xdylanm/noise/README.md

# Random Noise

A module in the Eurorack format for generating various types of noise.
