xdylanm/noise/docs/assets/images/BN_1K.png

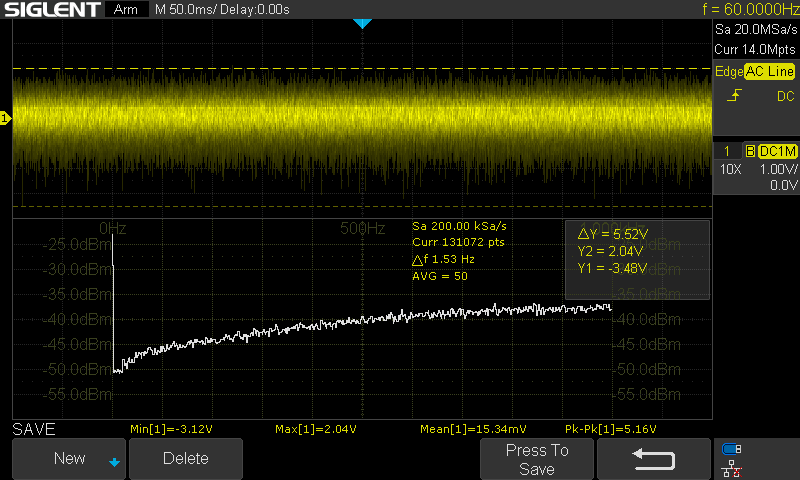
docs/assets/images/BN_1K.png
