xdylanm/noise/docs/assets/images/BN_10K.png

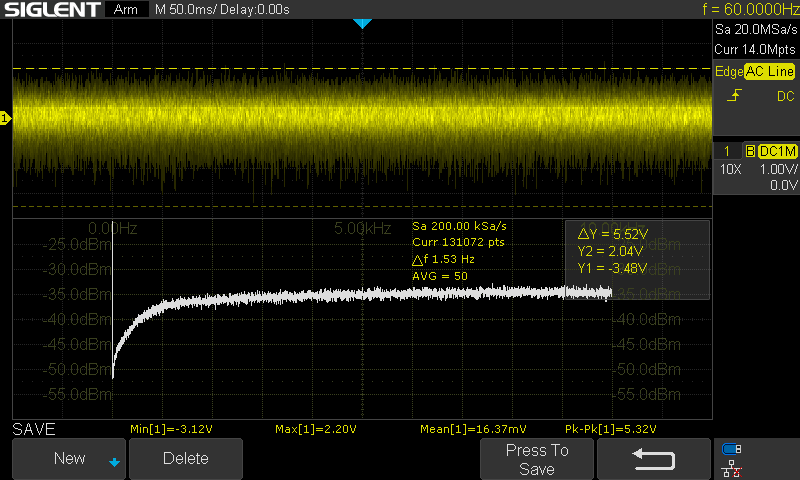
docs/assets/images/BN_10K.png
