xdylanm/noise/docs/assets/images/PN_10K.png

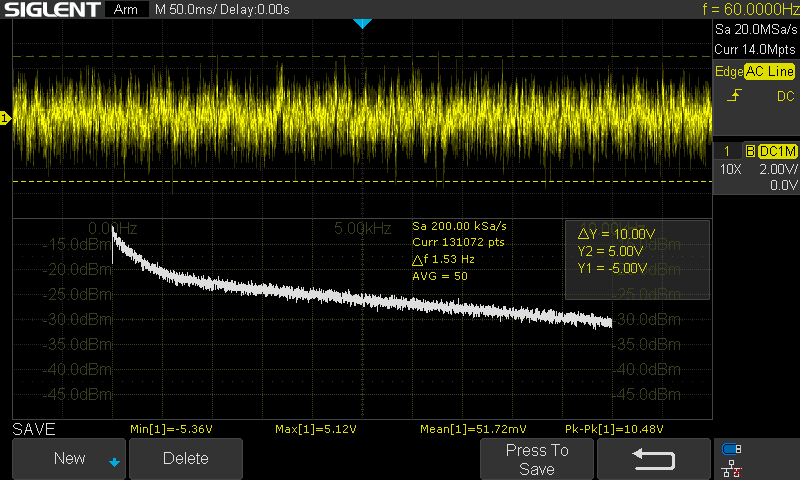
docs/assets/images/PN_10K.png
