xdylanm/noise/docs/assets/schematic.pdf

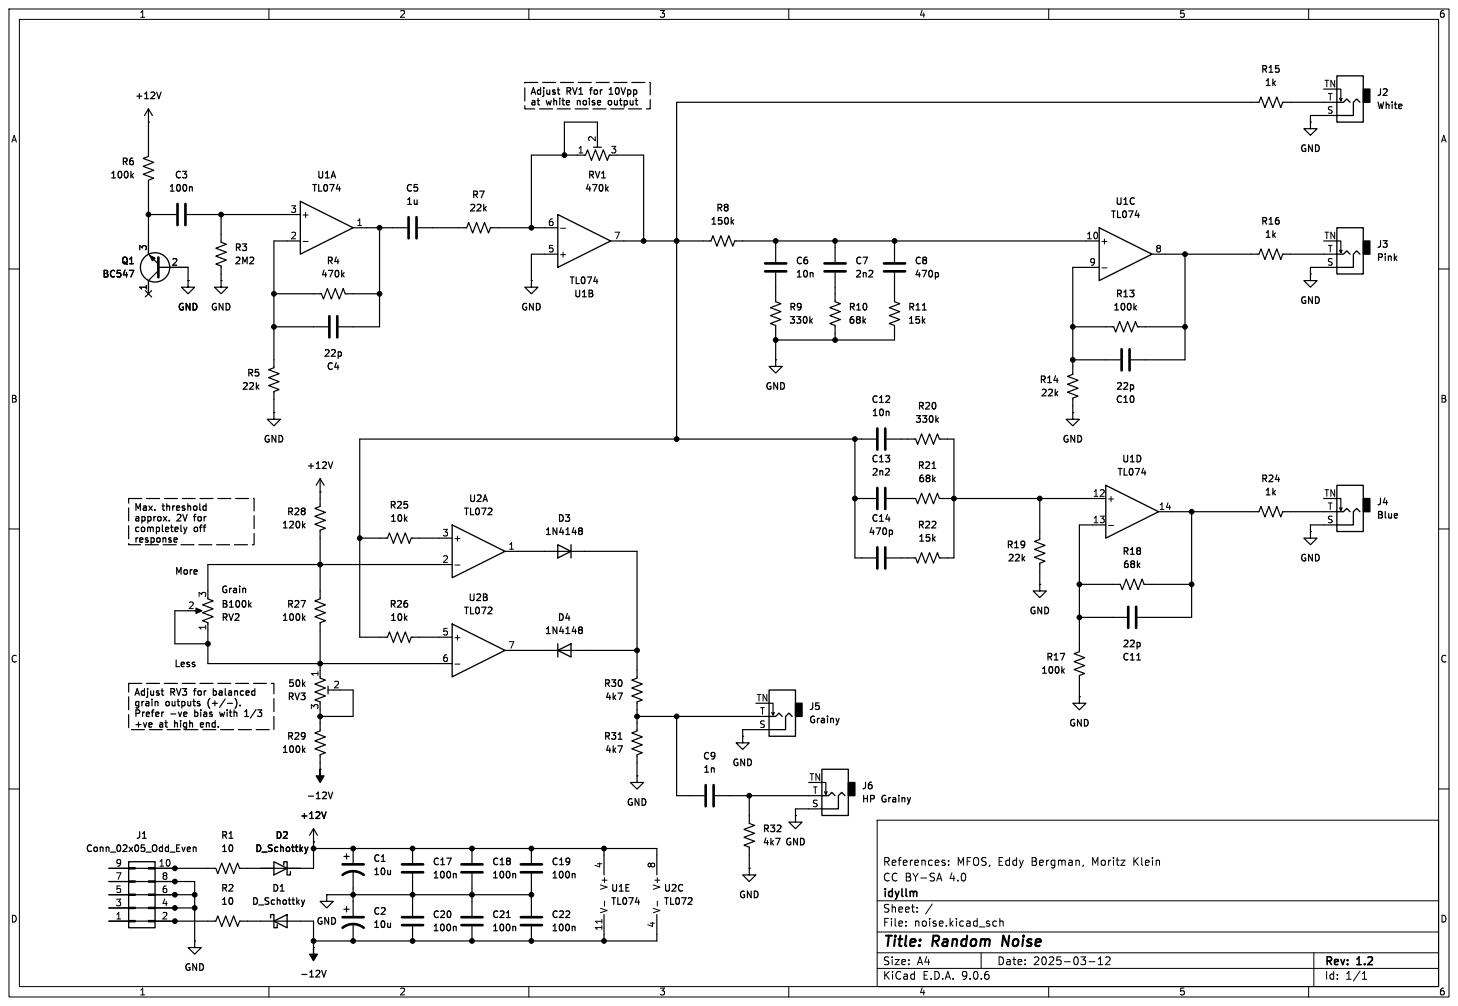
[picture p10: page 1]

Adjust RV1 for 10Vpp
at white noise output

idyllm
File: noise.kicad_sch Sheet: /
Id: 1/1 Title: Random Noise
