xdylanm/noise/hardware/noise/noise.kicad_pcb

## KiCad design hardware/noise/noise.kicad_pcb (2025-12-16)

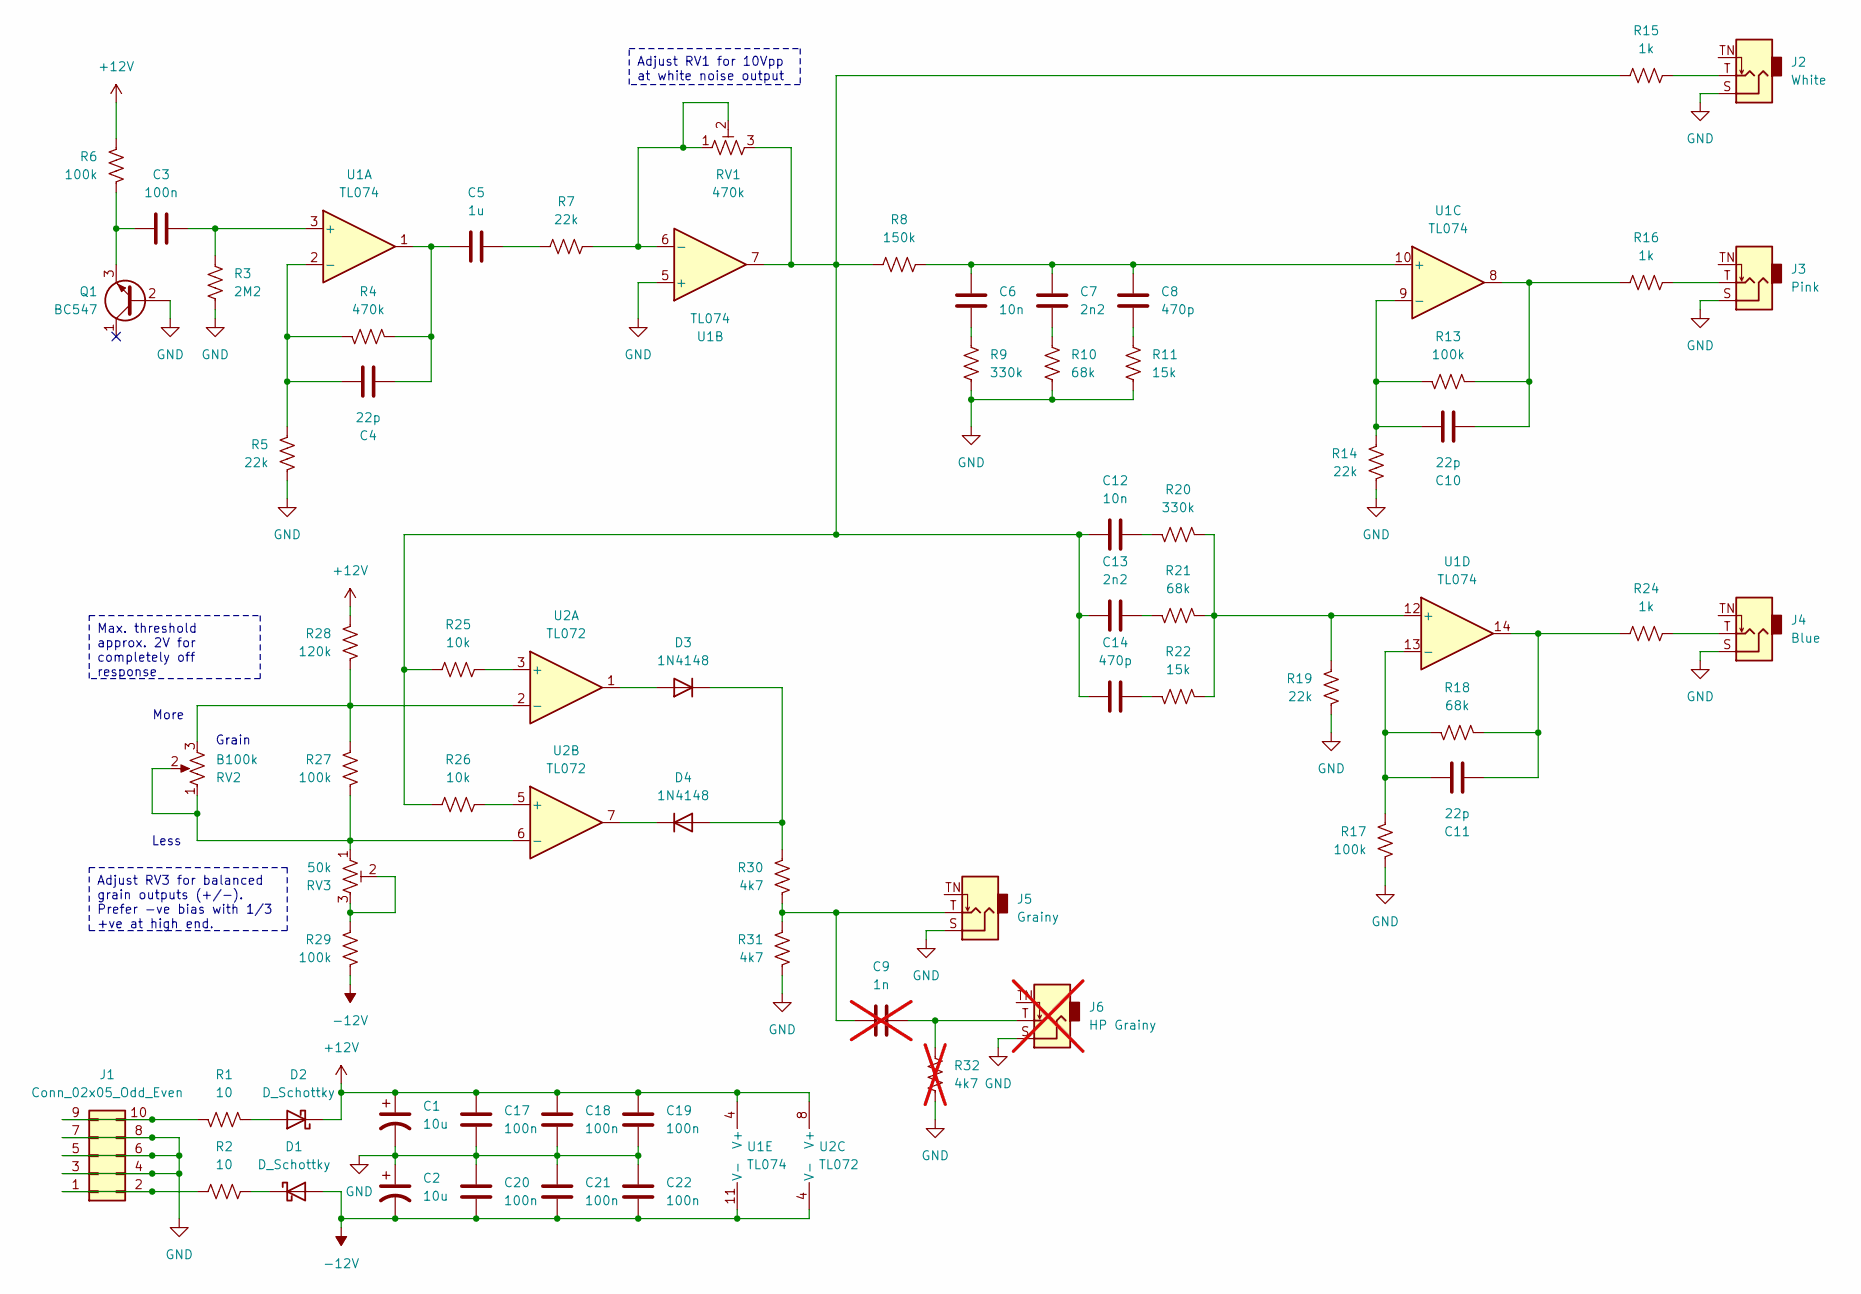
[picture p11: schematic noise.kicad_sch, Random Noise]

Parts:
C1, C2: 10u; CP_Radial_D5.0mm_P2.50mm
C3, C17, C18, C19, C20, C21, C22: 100n; C_Disc_D5.0mm_W2.5mm_P5.00mm
C4, C10, C11: 22p; C_Disc_D5.0mm_W2.5mm_P5.00mm
C5: 1u; C_Disc_D5.0mm_W2.5mm_P5.00mm
C6, C12: 10n; C_Rect_L7.0mm_W3.5mm_P5.00mm
C7, C13: 2n2; C_Rect_L7.0mm_W3.5mm_P5.00mm
C8, C14: 470p; C_Disc_D4.7mm_W2.5mm_P5.00mm
C9: 1n; C_Rect_L7.0mm_W3.5mm_P5.00mm; not fitted
D1, D2: D_Schottky; D_DO-41_SOD81_P3.81mm_Vertical_AnodeUp
D3, D4: 1N4148; D_DO-35_SOD27_P7.62mm_Horizontal
J1: Conn_02x05_Odd_Even; IDC-Header_2x05_P2.54mm_Horizontal
J2: White; Jack_3.5mm_QingPu_WQP-PJ323M_Horizontal
J3: Pink; Jack_3.5mm_QingPu_WQP-PJ323M_Horizontal
J4: Blue; Jack_3.5mm_QingPu_WQP-PJ323M_Horizontal
J5: Grainy; Jack_3.5mm_QingPu_WQP-PJ323M_Horizontal
J6: HP Grainy; Jack_3.5mm_QingPu_WQP-PJ323M_Horizontal; not fitted
Q1: BC547; TO-92_Inline_Wide
R1: 10; R_Axial_DIN0207_L6.3mm_D2.5mm_P10.16mm_Horizontal
R2: 10; R_Axial_DIN0207_L6.3mm_D2.5mm_P2.54mm_Vertical
R3: 2M2; R_Axial_DIN0204_L3.6mm_D1.6mm_P2.54mm_Vertical
R4: 470k; R_Axial_DIN0204_L3.6mm_D1.6mm_P2.54mm_Vertical
R5, R7, R14, R19: 22k; R_Axial_DIN0204_L3.6mm_D1.6mm_P2.54mm_Vertical
R6, R13, R17, R29: 100k; R_Axial_DIN0204_L3.6mm_D1.6mm_P2.54mm_Vertical
R8: 150k; R_Axial_DIN0204_L3.6mm_D1.6mm_P2.54mm_Vertical
R9, R20: 330k; R_Axial_DIN0204_L3.6mm_D1.6mm_P2.54mm_Vertical
R10, R18, R21: 68k; R_Axial_DIN0204_L3.6mm_D1.6mm_P2.54mm_Vertical
R11, R22: 15k; R_Axial_DIN0204_L3.6mm_D1.6mm_P2.54mm_Vertical
R15, R24: 1k; R_Axial_DIN0204_L3.6mm_D1.6mm_P2.54mm_Vertical
R16: 1k; R_Axial_DIN0207_L6.3mm_D2.5mm_P10.16mm_Horizontal
R25, R26: 10k; R_Axial_DIN0204_L3.6mm_D1.6mm_P2.54mm_Vertical
R27: 100k; R_Axial_DIN0207_L6.3mm_D2.5mm_P10.16mm_Horizontal
R28: 120k; R_Axial_DIN0204_L3.6mm_D1.6mm_P7.62mm_Horizontal
R30: 4k7; R_Axial_DIN0204_L3.6mm_D1.6mm_P7.62mm_Horizontal
R31: 4k7; R_Axial_DIN0204_L3.6mm_D1.6mm_P2.54mm_Vertical
R32: 4k7; R_Axial_DIN0204_L3.6mm_D1.6mm_P2.54mm_Vertical; not fitted
RV1: 470k; Potentiometer_Piher_PT-6-V_Vertical
RV2: B100k; Potentiometer_Bourns_PTV09A-2_Single_Horizontal
RV3: 50k; Potentiometer_Piher_PT-6-V_Vertical
U1: TL074; DIP-14_W7.62mm_Socket
U2: TL072; DIP-8_W7.62mm_Socket

Connections:
+12V: C1.1, C17.2, C18.2, C19.2, D2.1 (K), R6.1, R28.1, U1.4 (V+), U2.8 (V+)
-12V: C2.2, C20.1, C21.1, C22.1, D1.2 (A), R29.2, U1.11 (V-), U2.4 (V-)
GND: C1.2, C2.1, C17.1, C18.1, C19.1, C20.2, C21.2, C22.2, J1.3, J1.4, J1.5, J1.6, J1.7, J1.8, J2.S, J3.S, J4.S, J5.S, J6.S, Q1.2 (B), R3.2, R5.2, R9.2, R10.2, R11.2, R14.2, R17.2, R19.2, R31.2, R32.2, U1.5 (+)
unnamed: C4.2, C5.1, R4.2, U1.1
unnamed: C5.2, R7.1
unnamed: C6.1, R9.1
unnamed: C7.1, R10.1
unnamed: C8.1, R11.1
unnamed: C9.1, J6.T, R32.1
unnamed: C9.2, J5.T, R30.2, R31.1
unnamed: C10.2, R13.2, R16.1, U1.8
unnamed: C11.2, R18.2, R24.1, U1.14
unnamed: C12.1, R20.1
unnamed: C12.2, C13.2, C14.2, R8.1, R15.1, R25.1, R26.1, RV1.3, U1.7
unnamed: C13.1, R21.1
unnamed: C14.1, R22.1
unnamed: D1.1 (K), R2.2
unnamed: D2.2 (A), R1.2
unnamed: D3.2 (A), U2.1
unnamed: D3.1 (K), D4.2 (A), R30.1
unnamed: D4.1 (K), U2.7
unnamed: J1.1, J1.2, R2.1
unnamed: J1.9, J1.10, R1.1
unnamed: J2.T, R15.2
unnamed: J3.T, R16.2
unnamed: J4.T, R24.2
unnamed: C3.1, Q1.3 (E), R6.2
unnamed: R29.1, RV3.2, RV3.3
unnamed: C3.2, R3.1, U1.3 (+)
unnamed: C4.1, R4.1, R5.1, U1.2 (-)
unnamed: R7.2, RV1.1, RV1.2, U1.6 (-)
unnamed: C6.2, C7.2, C8.2, R8.2, U1.10 (+)
unnamed: C10.1, R13.1, R14.1, U1.9 (-)
unnamed: R19.1, R20.2, R21.2, R22.2, U1.12 (+)
unnamed: C11.1, R17.1, R18.1, U1.13 (-)
unnamed: R25.2, U2.3 (+)
unnamed: R27.1, R28.2, RV2.3, U2.2 (-)
unnamed: R26.2, U2.5 (+)
unnamed: R27.2, RV2.1, RV2.2, RV3.1, U2.6 (-)

Notes on the sheet:
Adjust RV1 for 10Vpp at white noise output
Max. threshold approx. 2V for completely off response
Adjust RV3 for balanced grain outputs (+/-). Prefer -ve bias with 1/3 +ve at high end.
Grain
More
Less

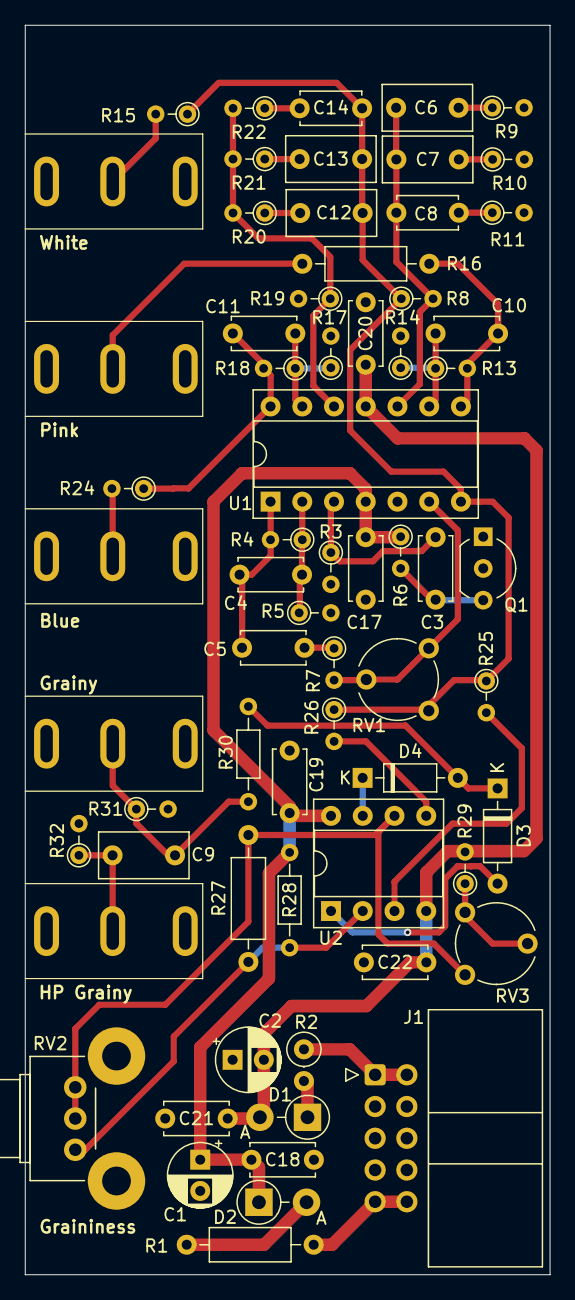
[picture p12: board noise.kicad_pcb from above]

Board: 2 copper layers, 42.0 x 100.0 mm, 66 parts (0 on the bottom side), 39 nets.
