xdylanm/noise/(commit log)

2025-03-08 Initial design and analysis with fractional filter for pink noise. Includes validating measurments for first and second stage gains for white noise and FLPF pink noise spectrum
    [FLPF_meas.csv, PN_spectrum_from_scope.csv, filters.kicad_pcb, filters.kicad_sch, noise.kicad_pcb, noise.kicad_sch]
2025-03-09 finished design checks on grain output and update schematic/layout to v1.1
    [BN_spectrum_10kHz_from_scope.csv, PN_spectrum_10kHz_from_scope.csv, filters.kicad_sch, noise.kicad_pcb, noise.kicad_sch]
2025-03-09 Submitted board v1.1 for fab
    [noise.kicad_pcb, noise.kicad_sch]
2025-03-12 Fixed bad orientation for IDC header to support horizontal and vertical plugs
    [noise.kicad_pcb, noise.kicad_sch]
2025-12-16 PCB silk tidy-up and added faceplate
    [noise.kicad_pcb, noise_faceplate.kicad_pcb, noise_faceplate.kicad_sch]
2025-12-16 Converted docs to mkdocs
    [BN_spectrum_10kHz_from_scope.csv, FLPF_meas.csv, PN_spectrum_10kHz_from_scope.csv, PN_spectrum_from_scope.csv, noise.kicad_sch]
2025-12-16 Updating gitignore, adding csvs for BOM and data
    [bom.csv, filter_meas.csv, filter_meas_2.csv, fitler_response_compare.csv]
2025-12-29 Doc cleanup, assembly guide, faceplate art
    [filter_response_compare.csv, noise.kicad_sch]
