xdylanm/noise/(notices)

Notices in the files:
hardware/noise/noise.kicad_pcb:
CC BY-SA 4.0
idyllm CC BY-SA 4.0
